rallepalaveev/analog/A2VGA.v1.6-hardware/README.md

A2VGA

This project is a new hardware implementation of the work done by Mark Aikens and David Kuder of the VGA analog card for Apple2.

The card is based on RPI Pico, 74LVC245 chips and a PLD. It is all through-hole. An improvement is that an ATF22V10 is used, which has sufficient I/O lines to allow that all necessaty bits of the address bus (A0-A10) are decoded for correct switching off of the ExtROM, in case the RPI firmware is using this memory. Additionally, the nLRESET signal can be fed to pin 30 of the Pico via a jumper, in case it is needed by future firmwares.

This v1.6 has IRQ capability and supports the A2USB firmware written by ThorstenB - https://github.com/ThorstenBr/A2USB 

Acknowledgements

This is a fork of David Kuder V2RetroComputing and ∀2 Retro Computing project with a new board design intended to fully support his software. The original design was posted by Mark Aikens Apple II VGA.
