rallepalaveev/analog/A2VGA.v1.3-hardware/A2VGA.v1.3.jpg.pdf

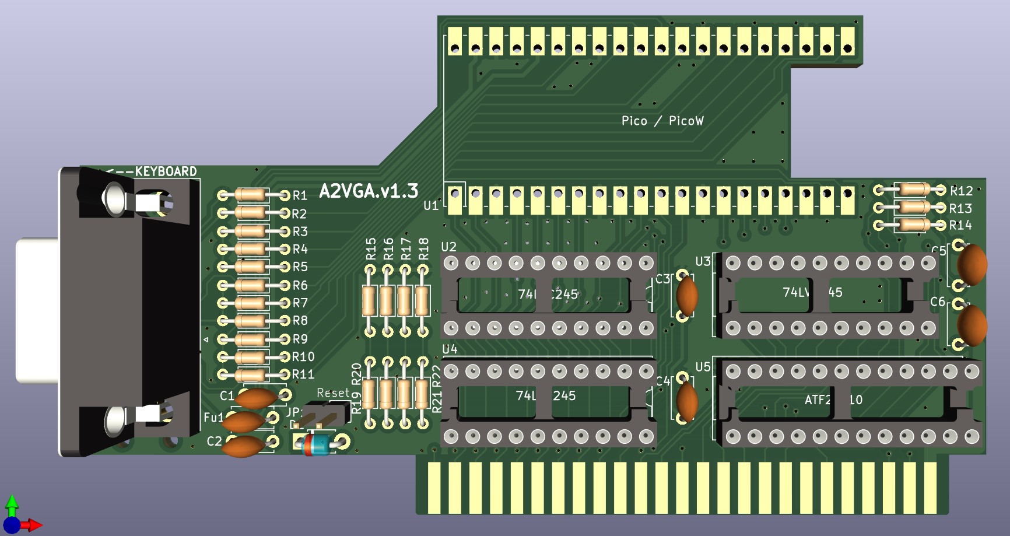
[picture p1: page 1]
