rallepalaveev/analog/Pravetz_font/Pravetz_font.png

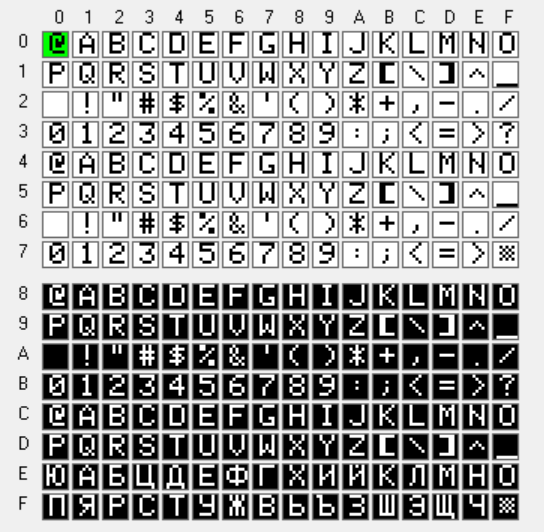
Pravetz_font/Pravetz_font.png
