rallepalaveev/analog/A2VGA.v1.6-hardware/A2VGA.v1.6.sch.pdf

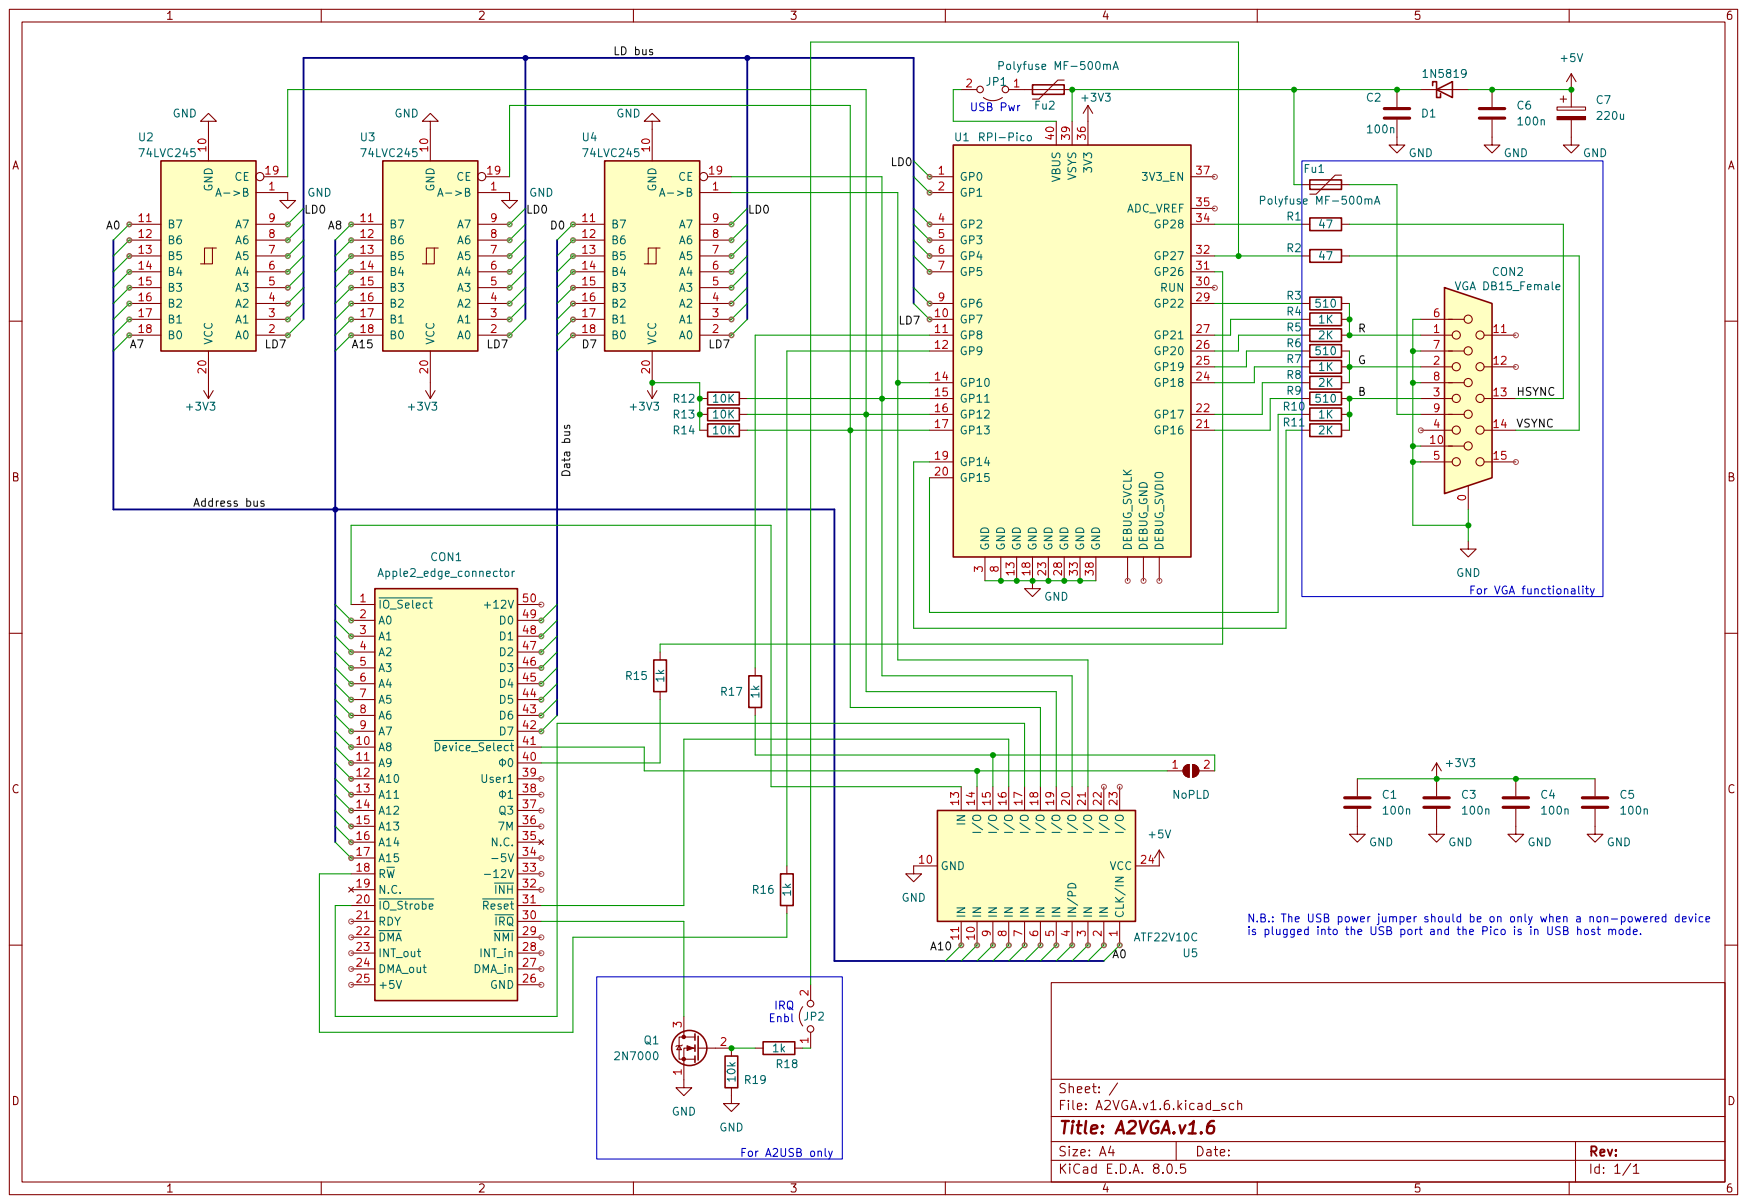
[picture p3: page 1]
