rallepalaveev/analog/A2VGA.v1.3-hardware/A2VGA.v1.3.sch.pdf

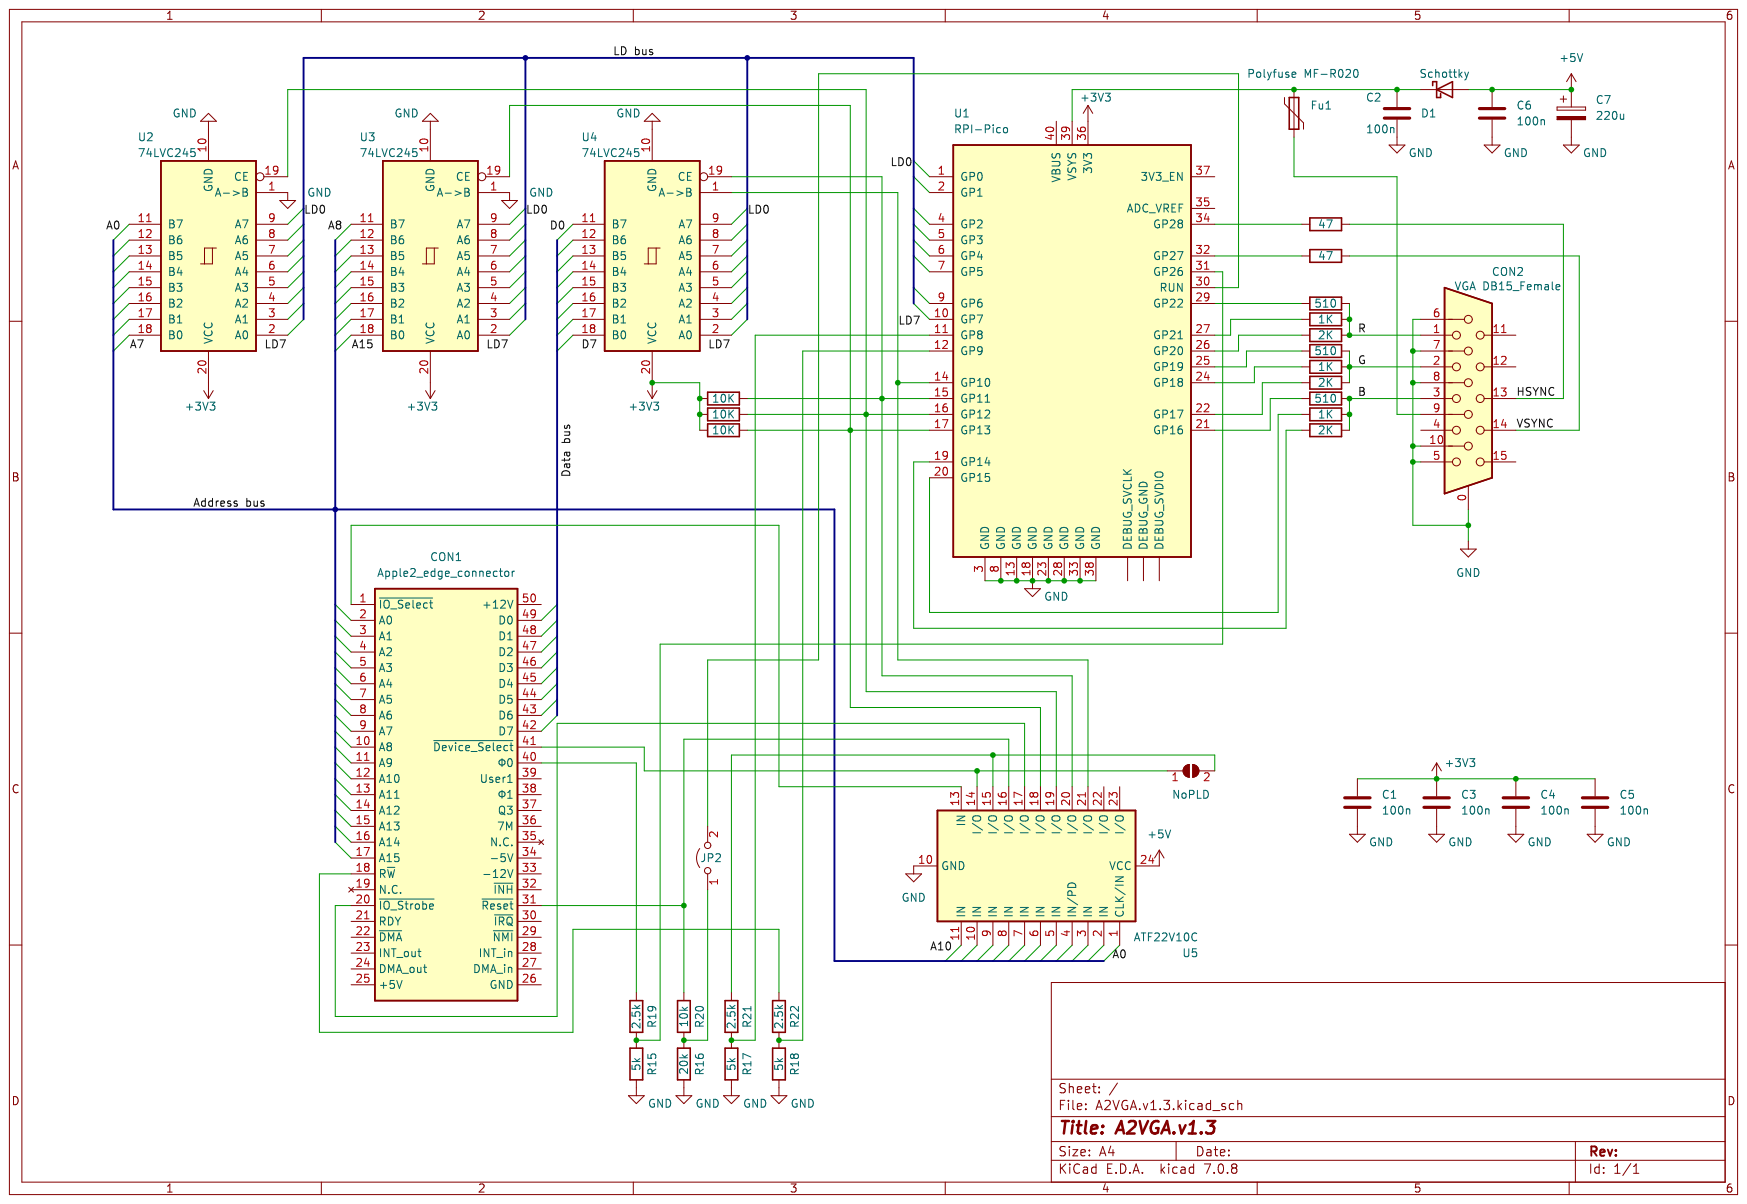
[picture p4: page 1]
