rallepalaveev/analog/A2VGA.v1.4-hardware/A2VGA.v1.4.sch.pdf

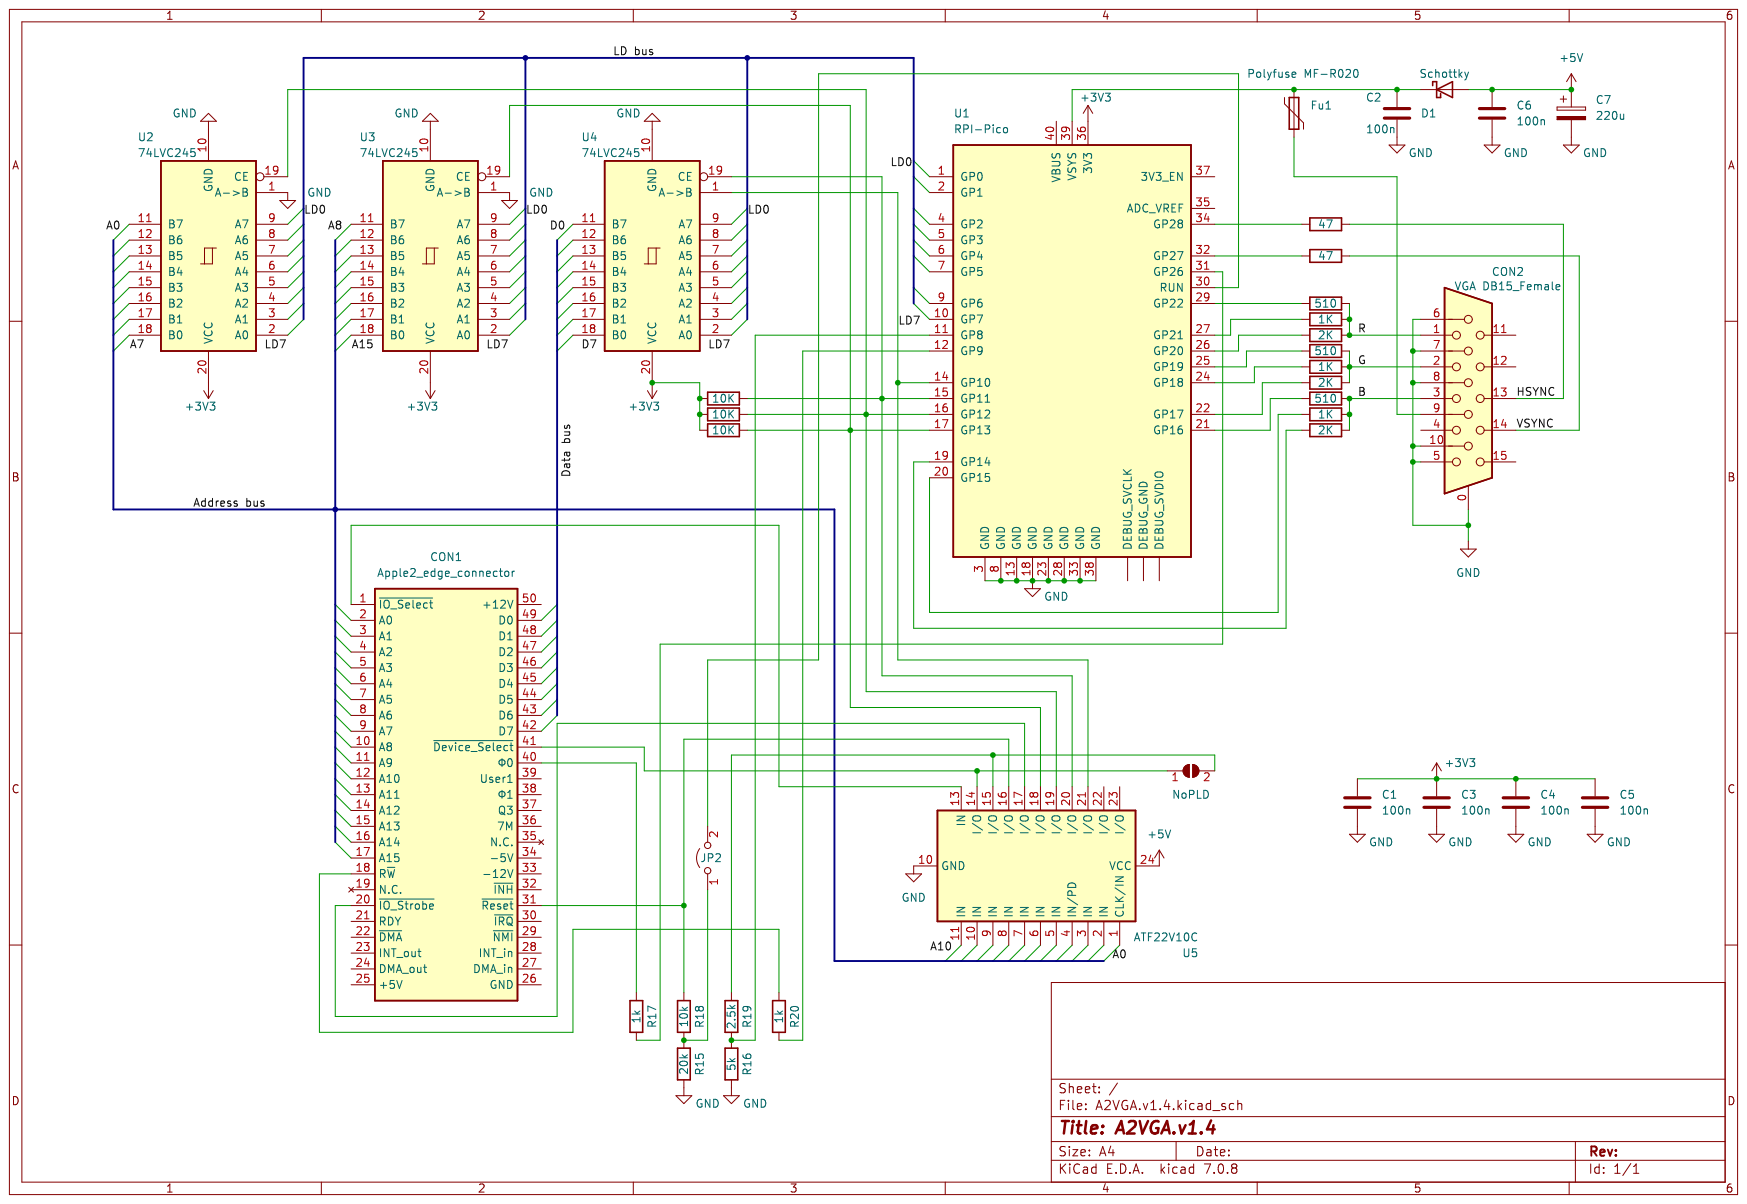
[picture p5: page 1]
