rallepalaveev/analog/A2VGA.v1.6-hardware/A2VGA.v1.6.kicad_pcb

## KiCad design A2VGA.v1.6-hardware/A2VGA.v1.6.kicad_pcb (2025-09-21)

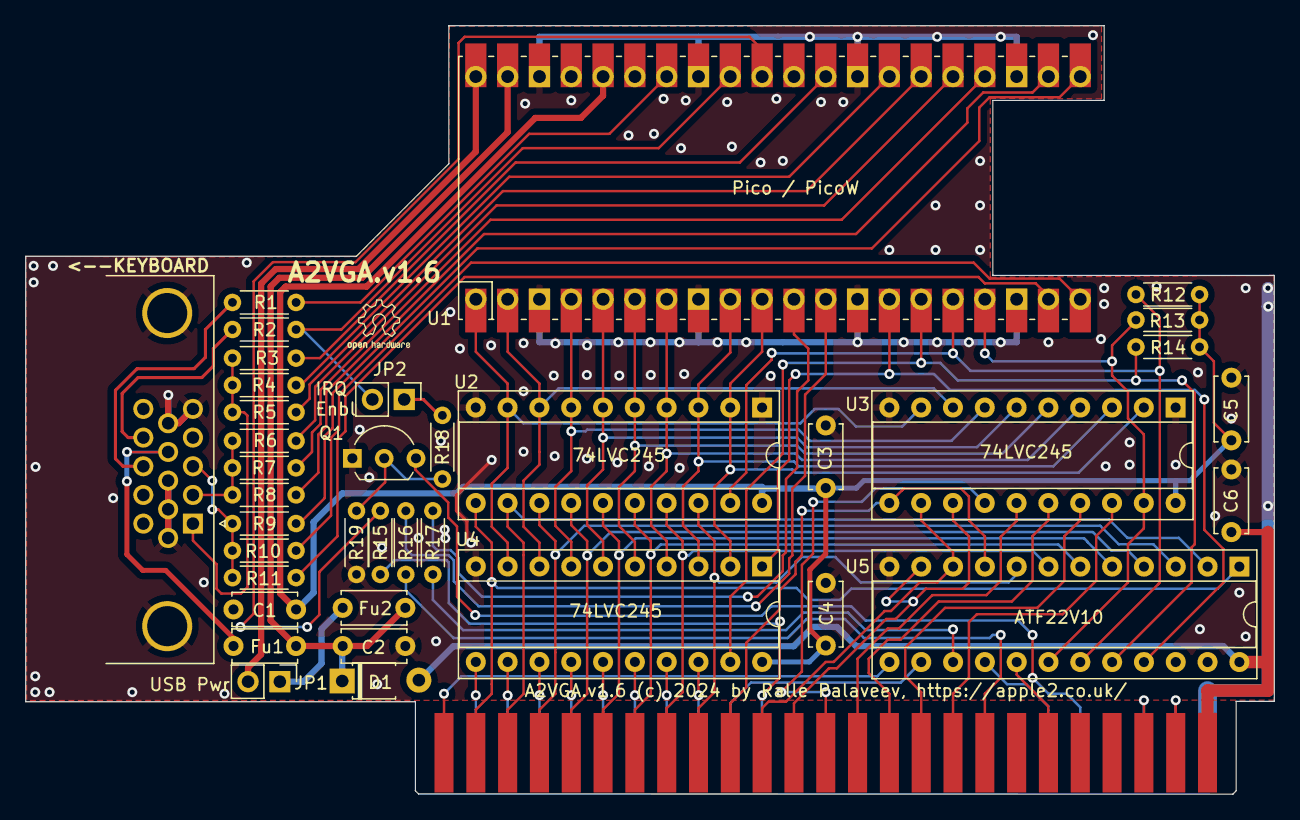
[picture p6: board A2VGA.v1.6.kicad_pcb from above]

Board: 2 copper layers, 99.7 x 61.4 mm, 37 parts (0 on the bottom side), 49 nets.

Parts:
C1, C2, C3, C4, C5, C6: 100n; C_Disc_D5.0mm_W2.5mm_P5.00mm
CON2: DB15_Female_HighDensity_MountingHoles; DSUB-15-HD_Female_Horizontal_P2.29x1.98mm_EdgePinOffset3.03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
D1: D_T-1_P5.08mm_Horizontal
Fu1, Fu2: 500mA; C_Disc_D5.0mm_W2.5mm_P5.00mm
JP1, JP2: PinHeader_1x02_P2.54mm_Vertical
Q1: 2N7000; TO-92L_Inline_Wide
R1, R2: 47; R_Axial_DIN0204_L3.6mm_D1.6mm_P5.08mm_Horizontal
R3, R6, R9: 510; R_Axial_DIN0204_L3.6mm_D1.6mm_P5.08mm_Horizontal
R4, R7, R10, R15, R16, R17, R18: 1k; R_Axial_DIN0204_L3.6mm_D1.6mm_P5.08mm_Horizontal
R5, R8, R11: 2k; R_Axial_DIN0204_L3.6mm_D1.6mm_P5.08mm_Horizontal
R12, R13, R14, R19: 10k; R_Axial_DIN0204_L3.6mm_D1.6mm_P5.08mm_Horizontal
U1: Pico / PicoW; RPi_PicoW_SMD_TH
U2, U3, U4: 74LVC245; DIP-20_W7.62mm_Socket
U5: ATF22V10; DIP-24_W7.62mm_Socket

Connections:
3.3V: C1.1, C3.1, C4.1, C5.1, R12.2, R13.2, R14.2, U1.36 (3V3), U2.20, U3.20, U4.20
5V: C6.2, D1.2, U5.24
A0: U2.11, U5.1
A1: U2.12, U5.2
A2: U2.13, U5.3
A3: U2.14, U5.4
A4: U2.15, U5.5
A5: U2.16, U5.6
A6: U2.17, U5.7
A7: U2.18, U5.8
A8: U3.11, U5.9
A9: U3.12, U5.10
A10: U3.13, U5.11
B0: R9.2, U1.21 (GPIO16)
B1: R10.2, U1.20 (GPIO15)
B2: R11.2, U1.19 (GPIO14)
B_out: CON2.3, R9.1, R10.1, R11.1
DATADIR: U1.14 (GPIO10), U4.1, U5.21
DATAOE: R14.1, U1.15 (GPIO11), U4.19, U5.20
Enable: R17.1, U5.15
G0: R6.2, U1.25 (GPIO19)
G1: R7.2, U1.24 (GPIO18)
G2: R8.2, U1.22 (GPIO17)
GND: C1.2, C2.1, C3.2, C4.2, C5.2, C6.1, CON2.0, CON2.5, CON2.6, CON2.7, CON2.8, CON2.10, Q1.1, R19.1, U1.3 (GND), U1.8 (GND), U1.13 (GND), U1.18 (GND), U1.23 (GND), U1.28 (GND), U1.33 (AGND), U1.38 (GND), U2.1, U2.10, U3.1, U3.10, U4.10, U5.12
G_out: CON2.2, R6.1, R7.1, R8.1
HSYNC: R1.2, U1.34 (GPIO28_ADC2)
HS_out: CON2.13, R1.1
L-ENBL: R17.2, U1.11 (GPIO8)
L-PHI0: R15.2, U1.31 (GPIO26_ADC0)
L-RW: R16.2, U1.12 (GPIO9)
LD0: U1.1 (GPIO0), U2.9, U3.9, U4.9
LD1: U1.2 (GPIO1), U2.8, U3.8, U4.8
LD2: U1.4 (GPIO2), U2.7, U3.7, U4.7
LD3: U1.5 (GPIO3), U2.6, U3.6, U4.6
LD4: U1.6 (GPIO4), U2.5, U3.5, U4.5
LD5: U1.7 (GPIO5), U2.4, U3.4, U4.4
LD6: U1.9 (GPIO6), U2.3, U3.3, U4.3
LD7: U1.10 (GPIO7), U2.2, U3.2, U4.2
LSBOE: R12.1, U1.16 (GPIO12), U2.19, U5.19
MSBOE: R13.1, U1.17 (GPIO13), U3.19, U5.18
R0: R3.2, U1.29 (GPIO22)
R1: R4.2, U1.27 (GPIO21)
R2: R5.2, U1.26 (GPIO20)
RGB-PWR: CON2.9, Fu1.1
R_out: CON2.1, R3.1, R4.1, R5.1
VBUS: JP1.2, U1.40 (VBUS)
VSYNC: JP2.2, R2.2, U1.32 (GPIO27_ADC1)
VSYS: C2.2, D1.1, Fu1.2, Fu2.2, U1.39 (VSYS)
VS_out: CON2.14, R2.1
