rallepalaveev/analog/(threads)

Thread 1 (2023-12-18):

Resistor voltage dividers values

rallepalaveev, 2023-12-18:
Resistor voltage dividers need more testing to determine which values work best. Currently I use 2.5k and 5k for RW, PHI0 and Enbl and 10k/20k for the Reset line.

ThorstenBr, 2023-12-19:
Hi Ralle,
I built the v1.3 version of your card - and noticed the resistor dividers were weak, so read-cycles wouldn't work. Write-cycles are less critical - since the PICO just needs to grab the data from the bus somewhere in between the 500ns of PHI0's high phase. But read-cycles are quite critical: the PICO needs to detect the rising edge of PHI0 almost instantly - otherwise it doesn't have enough time left to process the read request and respond with the correct data within the 500ns active phase of PHI0. Also, on the falling edge of PHI0, the PICO should release the bus within a few nanoseconds. This cannot work if the resistor values are too high - since the signal gets sloppy (takes too long to change from high to low, or vice versa).

Lower resistor values are good, since the falling/rising edges are sharp (fast). But the disadvantage is that it puts a lot of load on the signals - especially on the two signals shared with all other slots (PHI0 + RW).

I noticed you already changed the resistors in your v1.4 schematics, so you probably also already investigated this.

I checked the signals with a scope. Here's what I had done to my boards eventually:
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

- I used a 1K resistor for R19+R22 and removed R15+R18. So PHI0 and RW no longer have a divider, just a current-limiting 1K resistor. This is also how Vince Briel has done it in his variant of the card - see here: https://github.com/Retrotink/Apple-II-VGA/blob/main/Design%20Files/AppleIIVGA.pdf   I know quite a few people who have built this card - and do not have issues.
- The reasoning is that these signals are barely ever above 3.3V anyway. They are 5V TTL signals, but datasheets of LS TTL ICs specify a maximum voltage of 3.4V for high level. And the 1K resistors are still limiting the current, so even if the signal level got to the 3.4V, it couldn't damage much due to the very limited power.
- I kept the divider R21/R17 - and used similar resistors as you have now. The SELECT signal is either the slot specific DEV_SELECT from the bus, if the NO_PLD jumper was set - otherwise it's an output of the ATF GAL. In either case, it's not shared with anything, so putting some load on this signal cannot interfere with anything else in the system - as long as the load is within spec. The ATF GAL is able to drive up to 4mA, plenty of power, so that's not an issue at all. The 74LS138, however, which drives the DEV_SELECT signal on the bus, is rated to a maximum of 0.4mA only when outputting high level (at 3.4V). So, the LS138 would be fine with a load of up to 8.5K to GND. So, when the NO_PLD jumper was set, then the 2.5K/5K divider would still be slightly low - but not far from it.

Anyway, that's just what I had done with my boards. Thanks for making this DIP IC design! Fits the Apple II design perfectly... :)

rallepalaveev, 2023-12-19:
Hi Thorsten,

I fully agree with what you are suggesting, I was myself trying to find a balance between the current draw and the need for stable signals. I did not think about not using dividers actually on the PHI0 and RW lines, so thanks for the suggestion, I will do a revision.

:)

Closed 2024-01-03.

Thread 2 (2023-12-22):

v1.4 C7 missing?

kwadsten, 2023-12-22:
Hi, your schematic (A2VGA.v1.4-hardware/A2VGA.v1.4.sch.pdf) shows a 220u C7, but I'm not seeing that on the pcb anywhere.

Verault, 2023-12-22:
I noticed that as well. I assume it was a leftover from a previous version. Either way dont worry, it will build fine without it. Something else to note is I have seen boards labeled ver 1.2 and having two completely different values for the resistors. (R15 to R22). That is puzzling. How can there be two different versions of 1.2 gerbers?

rallepalaveev, 2024-01-03:
C7 missing is not a problem. The values of the resistors - I had to tweak them, work in progress.

Closed 2024-01-03.

Thread 3 (2024-01-01):

A2USB: Adding USB support to A2VGA cards...

ThorstenBr, 2024-01-01:
Hi Ralle,

I created a new firmware project - adding USB support for the PICO-based A2VGA cards. It currently emulates an Apple II Mouse Interface Card, using a standard USB mouse:

- The firmware project is available here: https://github.com/ThorstenBr/A2USB
- I also wrote a blog post about the project details: https://www.applefritter.com/content/a2usb-apple-ii-usb-mouse-interface-card-emulation

Proper mouse support on the Apple II requires an IRQ option. I simply rigged this to my existing PCBs, using a MOSFET and two resistors. When the USB firmware is used, the VGA output pins are no longer needed. So I reused the former VGA VSYNC output pin to trigger the IRQ instead.

Would you be interested in a small collaboration? I don't want to start another A2VGA PCB project - just to add a jumper and an optional MOSFET. I think it would be nice if the existing PCB projects just added the IRQ option. It would make these boards even more attractive. And obviously there are other possible applications. The USB support and Mouse Card emulation is only one such example.

Maybe have a look at the project and blog links above. Also contains a simple schematic showing what I added for the IRQ option. Let me know if you were interested in extending your PCB design.

Happy 2024!

rallepalaveev, 2024-01-03:
Hi Thorsten,

Happy new 2024!

Thanks for your message - this is a very interesting firmware that you have built, I was myself thinking of the many potential applications of the hardware in this fashion - software defined hardware, including of course a mouse emulation, so congratulations on achieving this milestone!

Meanwhile I have been working intensively for some time with Oliver Schmidt on a design, which includes IRQ functionality with the same idea - to have a simple hardware which can emulate many cards, depending on the software it is running. This is based on my initial A2Pico designs: https://github.com/rallepalaveev/a2pico , but the goal was to avoid the programmable logic altogether and achieve a really simple design. We have successfully done this on a TH board by using only the GPIOs and no programmable logic, based on Oliver's original code with some expansion.

So in case you are interested - Oliver and I would be very happy if you would join our collaboration and perhaps contribute to it. I propose that have an initial discussion by e-mail and see where this gets us, please reach me on rpalaveev@clintech.net

Thank you!

Ralle

rallepalaveev, 2024-01-07:
Addressed by A2VGA.v1.6.

Closed 2024-01-07.

Thread 4 (2024-01-09):

Board not working

kwadsten, 2024-01-09:
Hi, I build your v1.4 board but it's not quite working.

The display seems to be working OK in 40 and 80 column modes, but the the disk drive isn't recognized.  It boots right to the Applesoft prompt (with Apple IIE logo at the top of the screen).

When I do a PR#6 to boot the config floppy it doesn't do anything.

I tried adding the jumper, but it didn't help.  I assume the jumper doesn't do anything yet.

Any thoughts?

FYI - I have built the original A2VGA card (https://github.com/Retrotink/Apple-II-VGA) using the same firmware files and that one is working.

kwadsten, 2024-01-16:
I soldered the NO-PLD jumper on the back and removed the PLD chip and now it's working.  What is the purpose of the PLD?  Does it use the same .jed file as the A2VGA project or do you have a custom one?

ThorstenBr, 2024-01-16:
The PLD is required for extended functions, e.g. to enable use of the configuration utility to configure the card. Or for the Z80 firmware. Or for A2USB.

This card uses a GAL 22v10. You cannot use the PLD of other projects (e.g. using a GAL 16v8).

There is a PLD file in this project - in the earlier hardware folders. I thought there was also a .jed file somewhere in the project.
Otherwise use this .jed file: https://www.applefritter.com/files/2023/11/17/PICOPAL-N.jed_.zip

kwadsten, 2024-01-17:
OK, I unsoldered the NO-PLD jumper and re-flashed the PLD with your file.
I do see a .jed in one of your older hardware folders, but I used the one you linked above.
The drive now boots as expected.

I also compiled the latest A2VGA pico project .uf2 file ("main" branch) that enables saving.  Now all seems to be working great.  I do have to use a BASIC POKE to save the configuration, but assume they will update their config utility .dsk to support this soon.  (or I can just update my copy of their BASIC configuration program).

Thanks for your response and card design.  It's a beautiful, crisp display in a compact design.

ThorstenBr, 2024-01-17:
@kwadsten You can also use the firmware + config tool from here: https://github.com/V2RetroComputing/analog/issues/32 This version actually works - and has an additional feature...

rallepalaveev, 2024-01-21:
I uploaded the .jed file I use in v1.1 folder.

Closed 2024-01-17.

Thread 5 (2024-02-01):

I just had a few ver 1.6 PCBs printed that came in last night. I checked the github today and you deleted the hardware ver 1.6 folder five days ago. What happened?

Verault, 2024-02-01:
I just had some ver 1.6 PCBs printed that were delivered to me last night. I just checked the github today and you deleted the hardware ver 1.6 folder. What happened? Is there some kind of problem with the circuit design of Ver 1.6?

rallepalaveev, 2024-02-07:
The design is still good, I just have removed temporarily. If you need any files, let me know.

Closed 2024-02-07.

Thread 7 (2024-11-11):

V2 ANALOG Config Utility not work with PCB 1.6

mciucci65, 2024-11-11:
Hi first of all thanks a lot for your great job

I got an error with PCB 1.6 on config utility uploaded in firmware folder the error is:

UNABLE TO GET HARDWARE ID and UNABLE TO GET CONFIG BLOCK

I'm using your A2PICO CARD with A2retroNET.uf2 firmware.

I also tested original Analog WiFi firmware on card  RPI PICO WiFi but does not work

The card PCB 1.6  with  RPI PICO NO WiFi work except config utility. I also try old config utility from Markedev repository that worked on PC rev 1.4 but nothing

Can you help me ?

mciucci65, 2024-11-12:
RESOLVED !!!
Change slot from 7 to 5 works !!!!

Closed 2025-09-21.
