rallepalaveev/analog/(notices)

Notices in the files:
A2VGA.v1.6-hardware/A2VGA.v1.6.kicad_pcb:
A2VGA.v1.6, board design by R.Palaveev (c) 2024
Apple II VGA by Mark Aikens, (c) 2021-2022 &
V2 Analog by David Kuder, (c) 2022-2023
A2VGA.v1.6 (c) 2024 by Ralle Palaveev, https://apple2.co.uk
